Leo-Berman/Treadmill-To-Walking-Pad/Final_Paper/Treadmill-To-Walking-Desk_Final_Paper/Final_Product.jpg

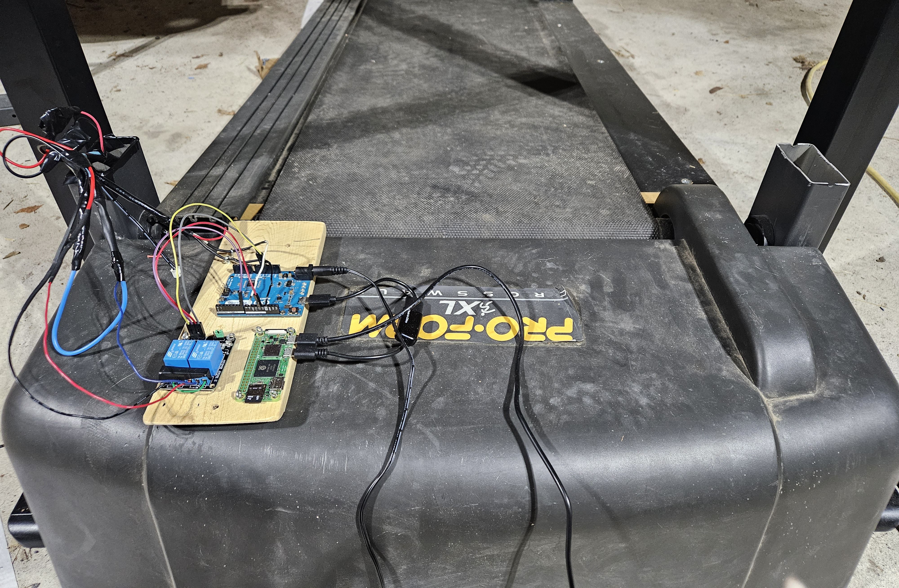
Final_Paper/Treadmill-To-Walking-Desk_Final_Paper/Final_Product.jpg
