Leo-Berman/Treadmill-To-Walking-Pad/site/my-app/build/index.html

Set yourself free.

Close

##### Treadmill Controlls

Up: Increases the treadmill incline.

Down: Decreases the treadmill incline.

Stop: Stop the incline motor.

Speed: Speed of the treadmill belt.

Up Down Stop

Speed: 0

© 2024 Liam Coleman and Leo Berman (https://github.com/Leo-Berman/Treadmill-To-Walking-Pad/) All Rights Reserved.
