Leo-Berman/Treadmill-To-Walking-Pad/(threads)

Thread 4 (2024-11-08):

different motor board

melidron, 2024-11-08:
I
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
have a treadmill with damaged control board and the motor board pins are like I show in the photo I send... Any idea if your project can be connected and control this board? Thanks in advanced

Leo-Berman, 2024-11-10:
Hi melidron, I'm not sure I can tell exactly what you're asking over this comment. Let me know if you'd like to hop on zoom/equivalent and we can chat for a bit, see if we can help.
