Leo-Berman/Treadmill-To-Walking-Pad/(commit log)

2024-01-08 Revert "Added some comments and made a second timed run function because the math looked wonky"
    This reverts commit d805372eb7da2cf3acc2b478b2f0544bb761c8cd.
    [Treadmill_Controller_1.ino]
2024-01-08 Change port to work with raspberry pi hopefully
2024-01-09 UART TESTING
2024-01-09 Fixed bug preventing string from being read
    [webserver.py]
2024-01-09 Removing some coments and fixing an error with timed run
    [Treadmill_Controller_1.ino]
2024-01-10 Add file to test without the serial device
2024-01-11 Mess with the flowbite svelt toast
2024-01-11 Fix relay reverse
