Leo-Berman/Treadmill-To-Walking-Pad/Final_Paper/Treadmill-To-Walking-Desk_Final_Paper/Everything_Wired.jpg

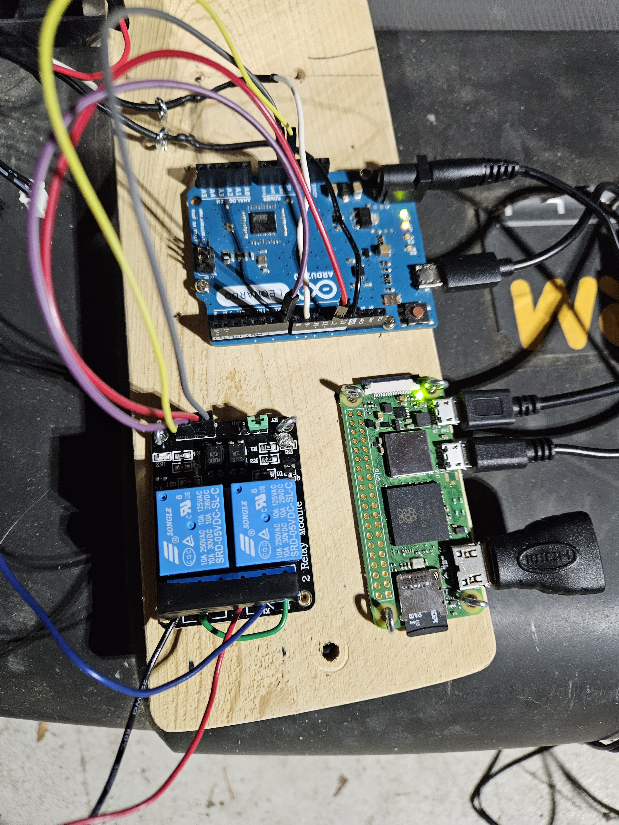
[picture p8: Final_Paper/Treadmill-To-Walking-Desk_Final_Paper/Everything_Wired.jpg]
Final_Paper/Treadmill-To-Walking-Desk_Final_Paper/Everything_Wired.jpg
